mintynet/esp32-slcan/README.md

# esp32-twai-can
# THIS IS FOR Board Definition > 3.x
This folder has the new TWAI based slcan software, this is tested on an ESP32-S3, SN65HVD230 CAN transceiver
<br>This does NOT require any additional libraries
<br>
<br>JAN2026 this DOES NOT work with ESP32-C3 variant, it comes up correctly but does NOT TX/RX any CAN traffic.

ESP32S3 with DoIP outside
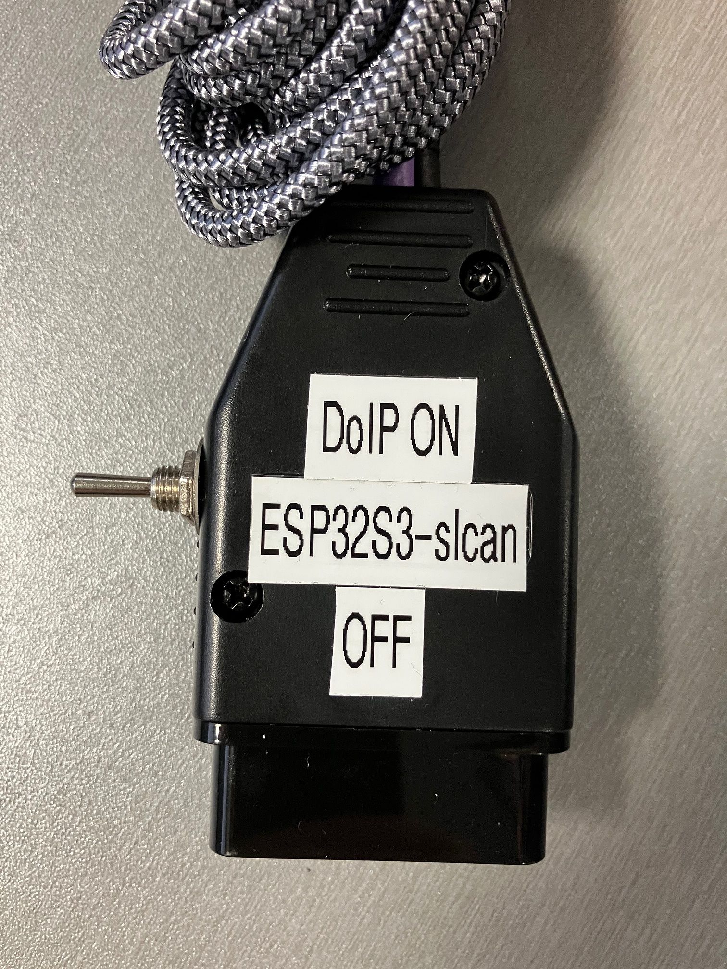
[picture p1: esp32s3-slcan-outside.jpg]
ESP32-S3 Outside

ESP32S3 with DoIP inside
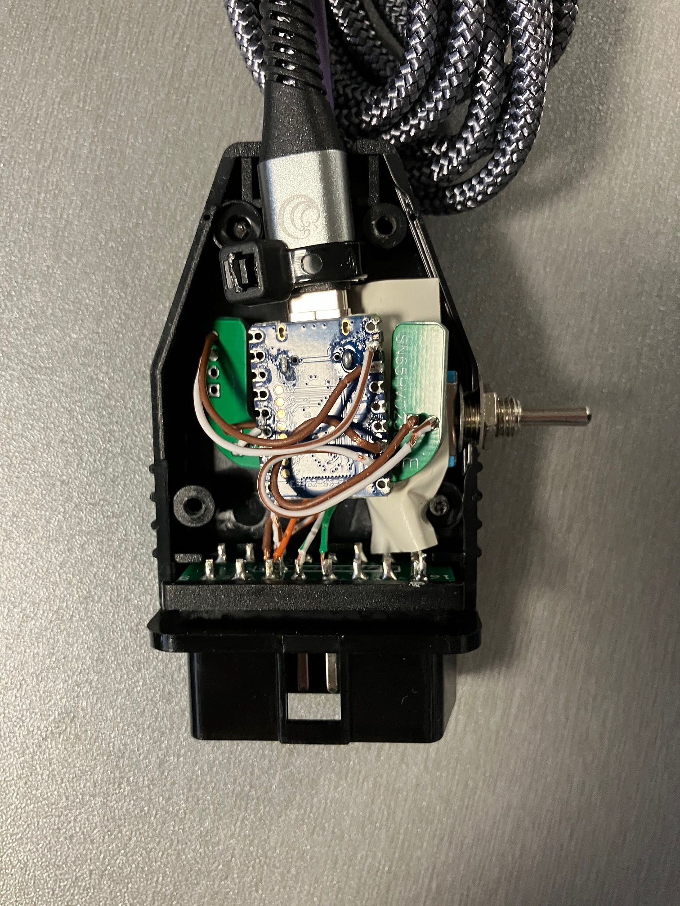
[picture p2: esp32s3-slcan-inside.jpg]
ESP32-S3 Inside


# esp32-slcan & esp32-slcan-nodisp
# THIS IS FOR Board Definition 2.x
This repository has an arduino sketch to create a slcan USB/Bluetooth device using the ESP32, SN65HVD230 CAN transceiver and 128x32 SSD1306.
<br>Requires the use of the following Arduino libraries
<br><br>https://github.com/nhatuan84/arduino-esp32-can-demo
<br>Adafruit_GFX
<br>Adafruit_SSD1306

Current "ESP32 ESP-WROOM-32 Wemos D1" uses CP2102 USB to TTL which is limited to 500kbps
Schematic for the device to follow

Bill of materials is in "esp32-slcan BOM.txt"

Diagram that shows built insides and required wiring
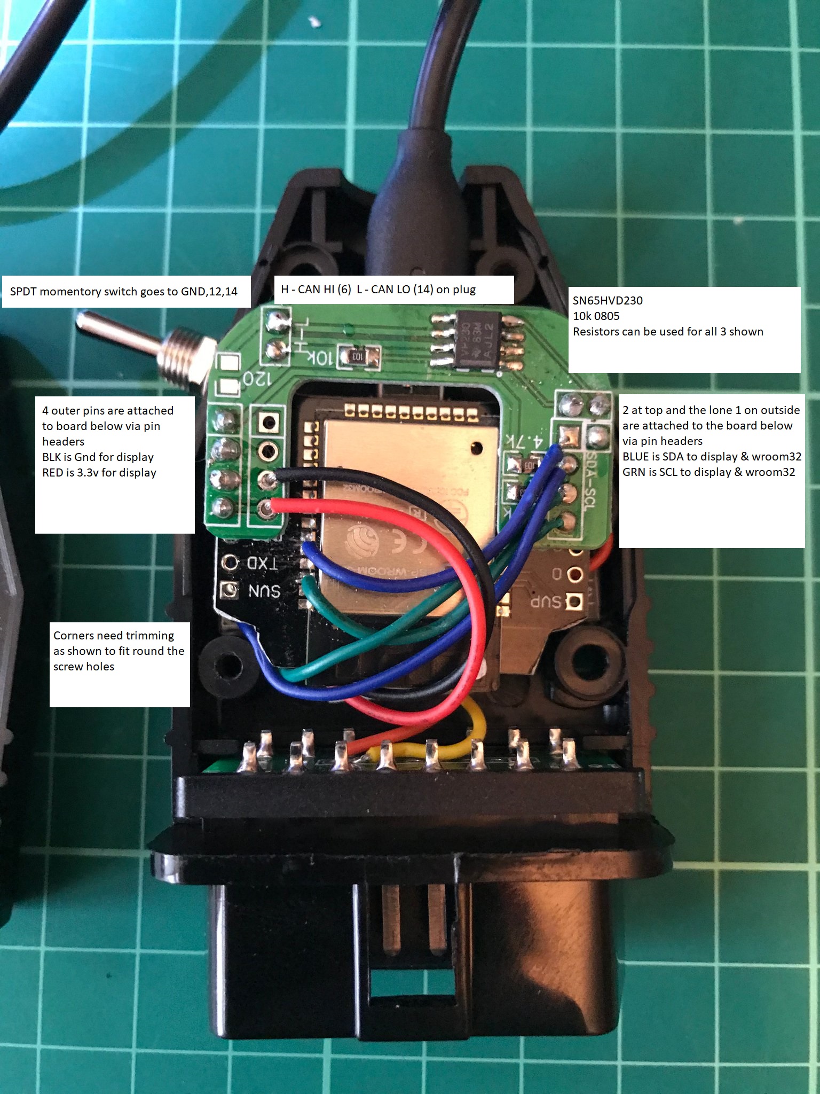
[picture p3: esp32-slcan.jpg]
Wiring

Can PCB without screen
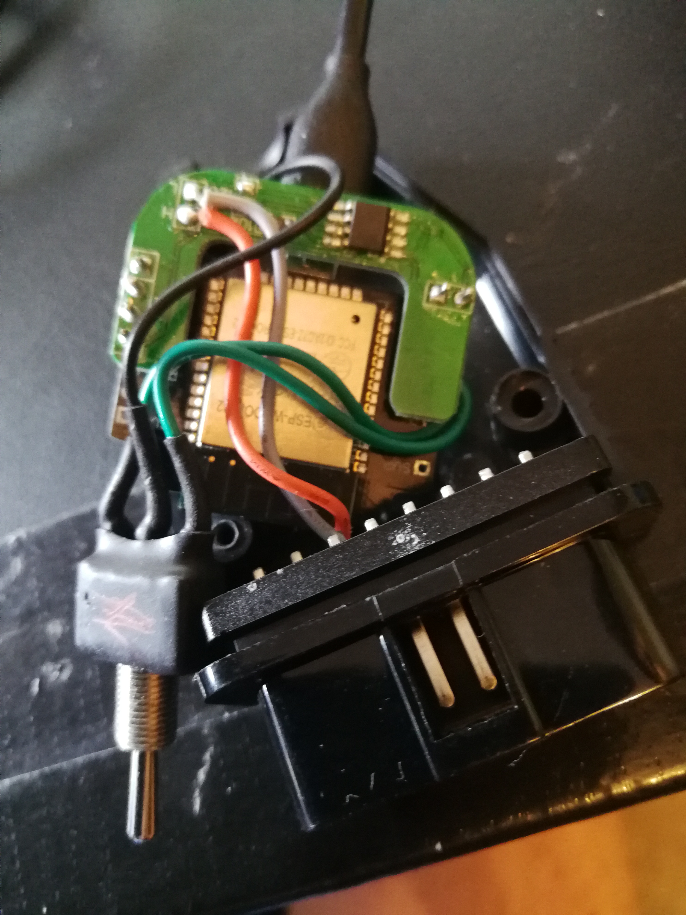
[picture p4: can-pcb.jpg]
Can pcb

Original with screen
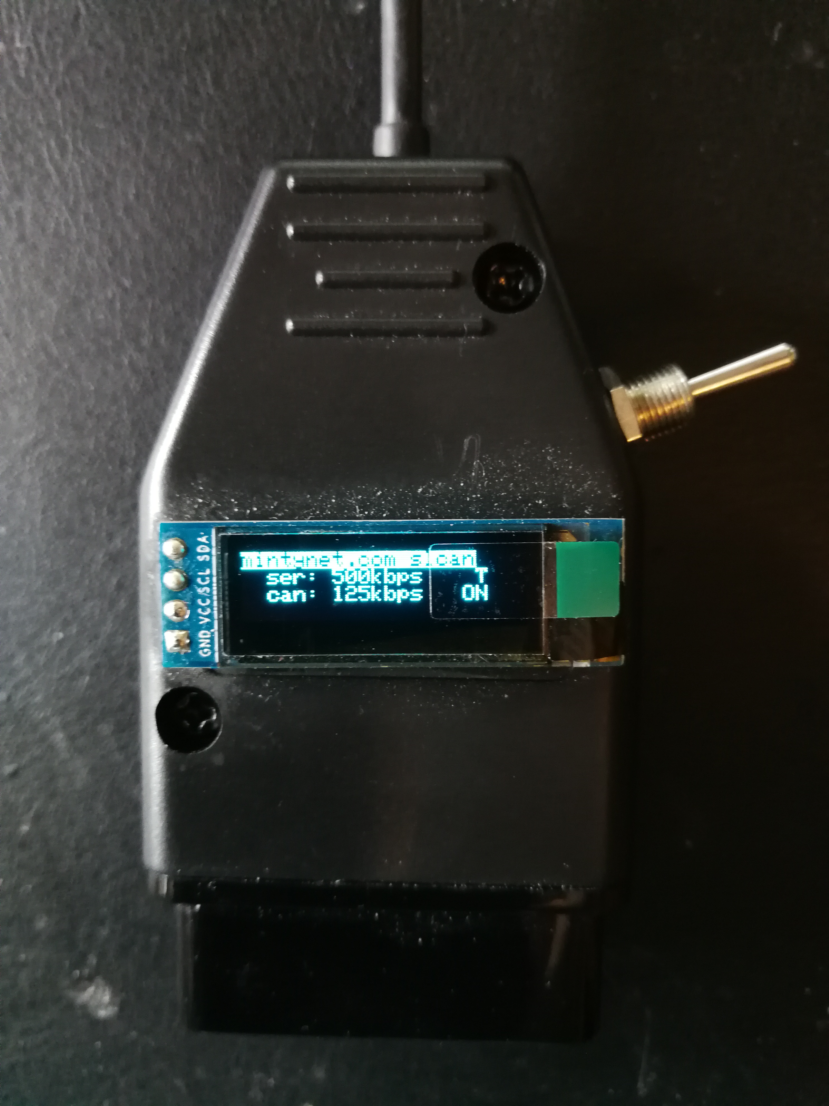
[picture p5: outside.jpg]
Outside

Inside original a
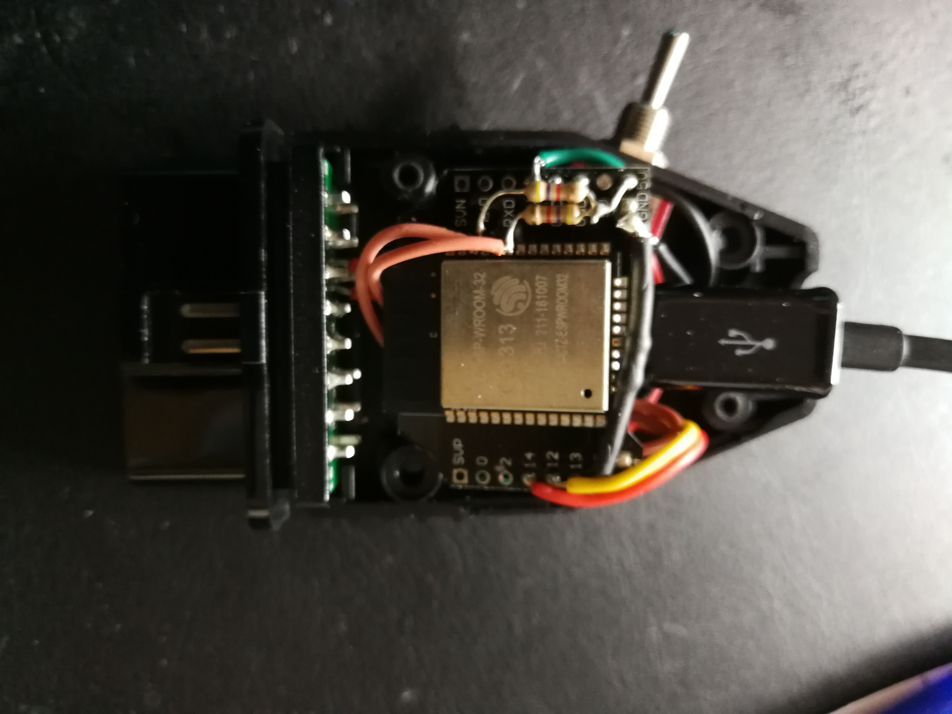
[picture p6: inside_above.jpg]
Inside above

Inside original b
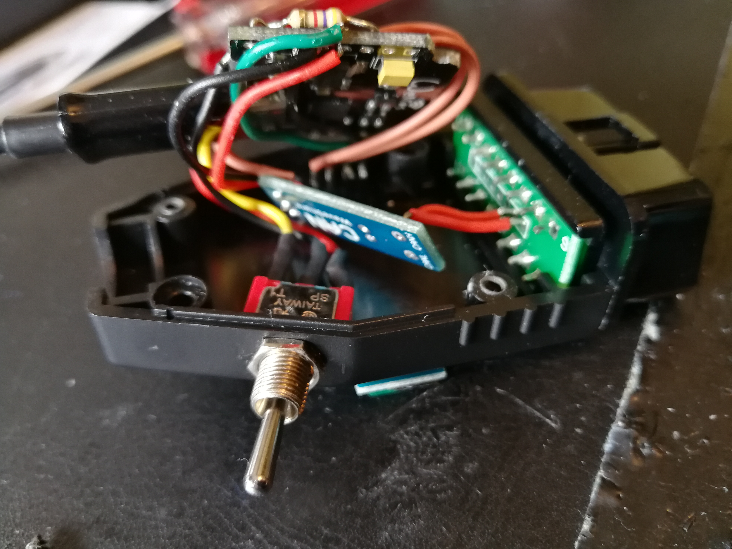
[picture p7: inside_under.jpg]
Inside under
