mintynet/esp32-slcan/(commit log)

2018-06-13 Added the arduino sketch
2018-07-11 updated the CAN transceiver details.
    TJA1050 will work but is 5V, where the SN65HVD230 is 3.3V
2018-09-11 new can-pcb from jlcpcb.com
2018-10-05 change switch to show msg stats
2018-10-12 modify wiring instructions
2019-01-12 Fixed incorrect nack on 800kbps selection
    [esp32-slcan-nodisp.ino, esp32-slcan.ino]
2019-01-28 added BOM file which includes links
2021-09-06 Fixed extended RX msg
    [esp32-slcan.ino]
2021-09-06 Fixed extended can RX
    [esp32-slcan-nodisp.ino]
2026-01-11 Update README.md for Board definition >3.x
    New TWAI based SLCAN sketch
2026-01-11 new TWAI based SLCAN for board definition >3.x
2026-01-11 Update esp32-twai-can.ino
    updated TX/RX timeout for messages
2026-01-12 Update esp32-twai-can.ino
    Set mode to NORMAL
2026-01-13 Update esp32-twai-can.ino
    Set initial t_config to 500k (standard OBD2 port speed)
2026-01-19 Update esp32-twai-can.ino
    Checks if ESP32S3 for 10k and 20k CAN definition
2026-02-06 Added esp32s3 pics
